merajhasan88/BEBCL-JPEG-Decoder/test_images/IMG20260716020409.jpg

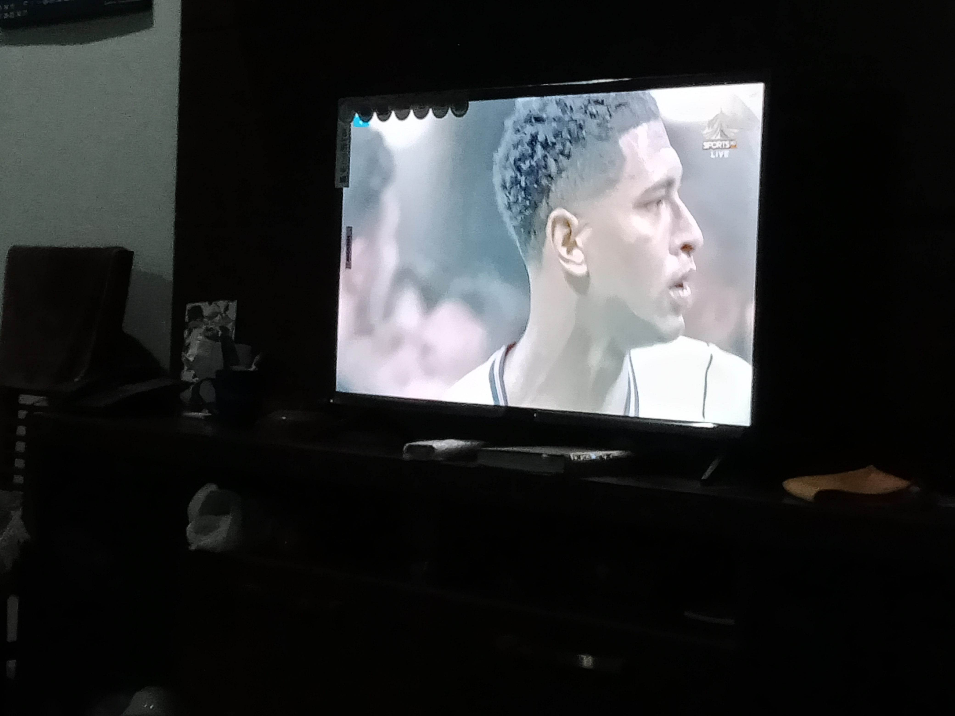
test_images/IMG20260716020409.jpg
