merajhasan88/BEBCL-JPEG-Decoder/bench/doc/head.md

# Benchmarks: this decoder vs. CPU decoders and other FPGA decoders

Measured on 2026-09-30 on the owner's laptop and the owner's EP2C5 board, and on 2026-10-03 on a
remote Artix-7 board (fpgas.online). **Everything here is
single-image decode time with the JPEG already in memory (CPU) or already streaming into the
decoder (FPGA): the time to get the file in and the pixels out is not included.** Generated by
`bench/make_benchmarks_md.py`.

## Setup

| | |
|---|---|
| Images | the owner's own photos (4000x3000 phone photos of a screen, a 3120x4160 4:2:2 photo, a 1944x2592 4:4:4 photo), three small files made from them, and donald.jpg (2048x1365, the photo used since the project started). Of these only `test_images/adapter.jpg` (the 3120x4160 photo) and the two `adp_`/`board_` files are in the repository; `scr_320x240_q90_420` was made from a screen photo, and the test set now has `adp_320x240_q90_420` (same settings, made from adapter.jpg) instead. `bench/run_bench.py` measures the files in `test_images/` by default |
| CPU | Intel Core i7-8550U (Kaby Lake R, 4 cores / 8 threads, 1.8 GHz base, 4.0 GHz turbo), Ubuntu 22.04 |
| CPU clock | the laptop's `performance` power profile, held for the CPU runs (`BENCH_POWER_PROFILE=performance python3 run_bench.py`); average clock measured with `perf stat` during every run: 3.4-3.9 GHz (the laptop throttles), so every comparison with the FPGA uses the CPU times rescaled to a steady 3.9 GHz from each run's cycle count (column "ms at 3.9 GHz"), the CPU's best case. The laptop is normally in its `power-saver` profile (~1 GHz): earlier versions of this file were measured that way without anyone noticing, which made every CPU decoder look about 4-5x slower (see "Correction" below) |
| CPU decoders | libjpeg-turbo 2.1.2 (C API, `-O2 -march=native` harness), libjpeg 9e (built by `bench/tools.py`), stb_image v2.27, Pillow 9.0.1, OpenCV 4.7.0 (`cv2.setNumThreads(1)`), FFmpeg 4.4.2 (its own mjpeg decoder, `-threads 1`, converting to RGB24 like the others); on the 2026-10-04 photo run also zune-jpeg 0.4.21 (Rust, run-time SIMD, built with Rust 1.99) and Go 1.27.1's standard `image/jpeg` (YCbCr converted to RGBA with `image/draw`); each pinned to one core (`taskset -c 3`), repeated in ~0.1 s batches for >= 1.5 s, median batch reported |
| This decoder | the fast core (`FAST=1`, MCU order, RGB) at 95 MHz on the EP2C5 (`boards/ep2c5/fpga_jtag`, 4,473 of 4,608 LEs at the time, timing met at 95 MHz): **clock counts measured on the board** with the decoder clock gated so that streaming time is excluded, identical to the cycle-exact simulation for every image; and the compact core (`FAST=0`, `boards/ep2c5/fpga`, 50 MHz) from simulation |
| Output | CPU decoders: RGB, raster order (libjpeg-turbo default and Pillow/OpenCV with smoothed chroma, `-nosmooth` and this decoder with replicated chroma: same pixels as libjpeg 9e `djpeg -nosmooth`); this decoder: RGB in MCU order (8x8 / 16x16 tiles, each pixel tagged with x, y) |
| Energy | CPU: RAPL package energy over the run / decodes (includes background package power); FPGA: PowerPlay vectorless estimate x decode time (low confidence) - neither is precise enough to compare energy closely |

Not measured: the laptop's Intel UHD 620 hardware JPEG decoder and GPU decoders (not available here).

## Results per image
