merajhasan88/BEBCL-JPEG-Decoder/tb/corpus/SOURCES.md

# Test corpus: origin of every file

Generated by `scripts/make_corpus.py` from the project owner's photo `test_images/adapter.jpg` with ImageMagick and libjpeg-turbo `cjpeg`. Metadata is stripped.

| file | source photo | size | scaling | settings |
|---|---|---|---|---|
| adp_8x8_q10_gray.jpg | adapter.jpg | 8x8 | centre crop | grey, -baseline -quality 10 |
| adp_1x1_q50_420.jpg | adapter.jpg | 1x1 | centre crop | -baseline -quality 50 -sample 2x2 |
| adp_3x5_q50_420.jpg | adapter.jpg | 3x5 | centre crop | -baseline -quality 50 -sample 2x2 |
| adp_5x3_q50_420.jpg | adapter.jpg | 5x3 | centre crop | -baseline -quality 50 -sample 2x2 |
| adp_4x6_q50_422.jpg | adapter.jpg | 4x6 | centre crop | -baseline -quality 50 -sample 2x1 |
| adp_13x11_q40_gray.jpg | adapter.jpg | 13x11 | centre crop | grey, -baseline -quality 40 |
| adp_16x16_q25_420.jpg | adapter.jpg | 16x16 | centre crop | -baseline -quality 25 -sample 2x2 -optimize |
| adp_16x16_q25_gray.jpg | adapter.jpg | 16x16 | centre crop | grey, -baseline -quality 25 -optimize |
| adp_17x33_q40_420.jpg | adapter.jpg | 17x33 | centre crop | -baseline -quality 40 -sample 2x2 |
| adp_32x32_q25_420.jpg | adapter.jpg | 32x32 | centre crop | -baseline -quality 25 -sample 2x2 -optimize |
| adp_32x32_q25_444.jpg | adapter.jpg | 32x32 | centre crop | -baseline -quality 25 -sample 1x1 -optimize |
| adp_33x18_q40_440.jpg | adapter.jpg | 33x18 | centre crop | -baseline -quality 40 -sample 1x2 |
| adp_40x40_q40_lumasub.jpg | adapter.jpg | 40x40 | centre crop | -baseline -quality 40 -sample 1x1,2x2,2x2 |
| adp_48x40_q40_mixed.jpg | adapter.jpg | 48x40 | centre crop | -baseline -quality 40 -sample 2x2,1x2,2x1 |
| adp_40x50_q30_420_rst3.jpg | adapter.jpg | 40x50 | centre crop | -baseline -quality 30 -sample 2x2 -restart 3B |
| adp_45x37_q30_420_rst2.jpg | adapter.jpg | 45x37 | centre crop | -baseline -quality 30 -sample 2x2 -restart 2B |
| adp_45x37_q30_422.jpg | adapter.jpg | 45x37 | centre crop | -baseline -quality 30 -sample 2x1 |
| adp_45x37_q30_440_rst1row.jpg | adapter.jpg | 45x37 | centre crop | -baseline -quality 30 -sample 1x2 -restart 1 |
| adp_45x37_q30_gray_rst3.jpg | adapter.jpg | 45x37 | centre crop | grey, -baseline -quality 30 -restart 3B |
| adp_64x64_q25_420.jpg | adapter.jpg | 64x64 | centre crop | -baseline -quality 25 -sample 2x2 -optimize |
| board_352x32_q6_420.jpg | adapter.jpg | 352x32 | centre band | -baseline -quality 6 -sample 2x2 |
| wide_352x20_q20_420.jpg | adapter.jpg | 352x20 | centre band | -baseline -quality 20 -sample 2x2 |
| wide_368x20_q20_420.jpg | adapter.jpg | 368x20 | centre band | -baseline -quality 20 -sample 2x2 |
| wide_384x12_q20_444.jpg | adapter.jpg | 384x12 | centre band | -baseline -quality 20 -sample 1x1 |
| wide_576x10_q20_422.jpg | adapter.jpg | 576x10 | centre band | -baseline -quality 20 -sample 2x1 |
| wide_592x10_q20_422.jpg | adapter.jpg | 592x10 | centre band | -baseline -quality 20 -sample 2x1 |
| wide_1152x6_q20_gray.jpg | adapter.jpg | 1152x6 | centre band | grey, -baseline -quality 20 |
| wide_1160x6_q20_gray.jpg | adapter.jpg | 1160x6 | centre band | grey, -baseline -quality 20 |
| adp_160x120_q95_444.jpg | adapter.jpg | 160x120 | centre crop | -baseline -quality 95 -sample 1x1 |
| adp_320x240_q90_420.jpg | adapter.jpg | 320x240 | centre crop | -baseline -quality 90 -sample 2x2 |
| adp_240x320_q95_422_rst4.jpg | adapter.jpg | 240x320 | centre crop | -baseline -quality 95 -sample 2x1 -restart 4B |
| adp_256x64_q98_gray.jpg | adapter.jpg | 256x64 | centre crop | grey, -baseline -quality 98 |
| adp_45x37_q30_progressive_UNSUPPORTED.jpg | adapter.jpg | 45x37 | centre crop | -baseline -quality 30 -progressive |
| adp_40x40_q20_sof1_UNSUPPORTED.jpg | adapter.jpg | 40x40 | centre crop | -quality 20 -sample 2x2 |
| adp_45x37_q30_422_exifthumb.jpg | adapter.jpg | 45x37 | centre crop | adp_45x37_q30_422 with an APP1 embedding adp_8x8_q10_gray and a COM containing FF D9 |
