merajhasan88/BEBCL-JPEG-Decoder/tb/corpus/adp_160x120_q95_444.jpg

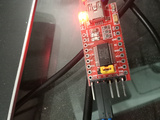
tb/corpus/adp_160x120_q95_444.jpg
