merajhasan88/BEBCL-JPEG-Decoder/tb/corpus/adp_240x320_q95_422_rst4.jpg

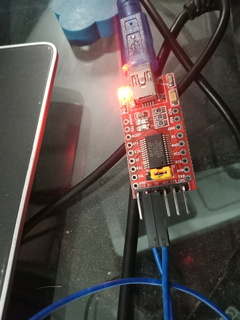
tb/corpus/adp_240x320_q95_422_rst4.jpg
