merajhasan88/BEBCL-JPEG-Decoder/tb/stream_tests2.txt

done mcu
done fmcu
done frbox
done frfancy
done rbox
done rfancy
done ep2c5
done noyrgb
STREAM TESTS 80/80 passed
stream_rc=0
