merajhasan88/BEBCL-JPEG-Decoder/test_images/IMG20260405182829.jpg

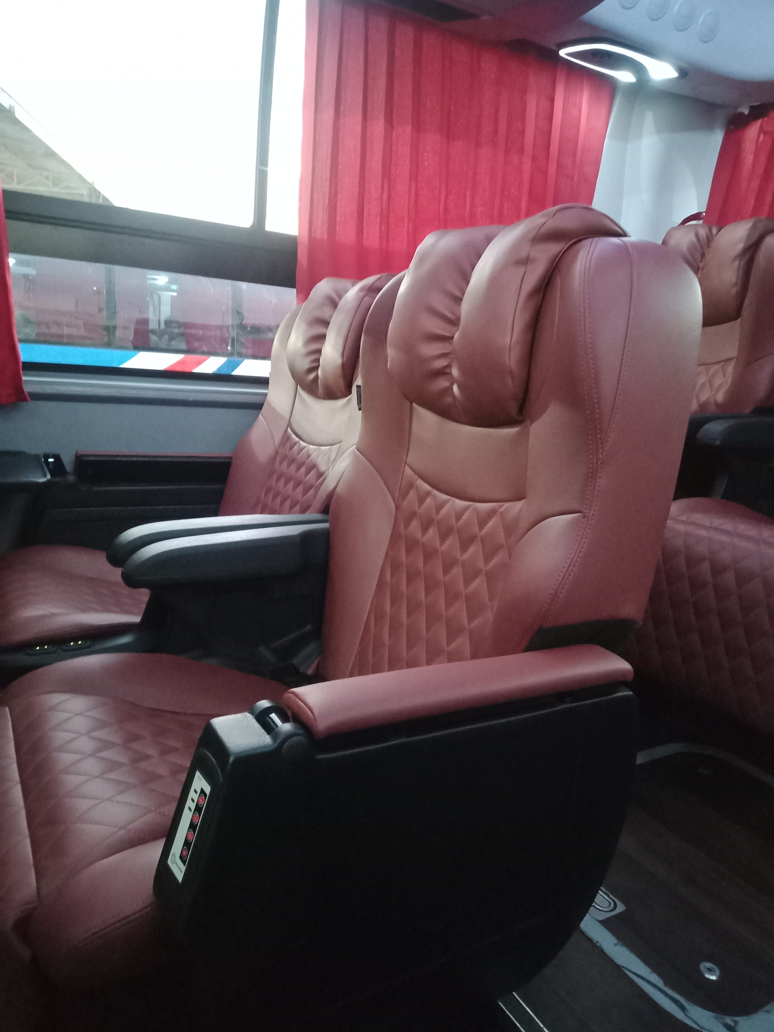
test_images/IMG20260405182829.jpg
