merajhasan88/BEBCL-JPEG-Decoder/test_images/IMG20260405182833.jpg

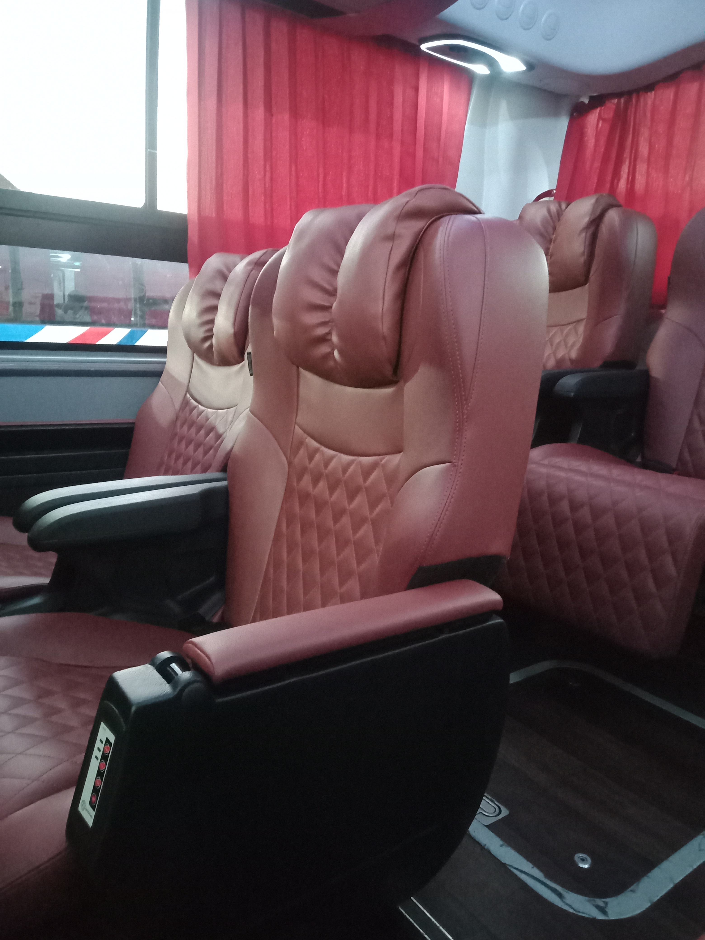
test_images/IMG20260405182833.jpg
