merajhasan88/BEBCL-JPEG-Decoder/test_images/IMG20260425135544.jpg

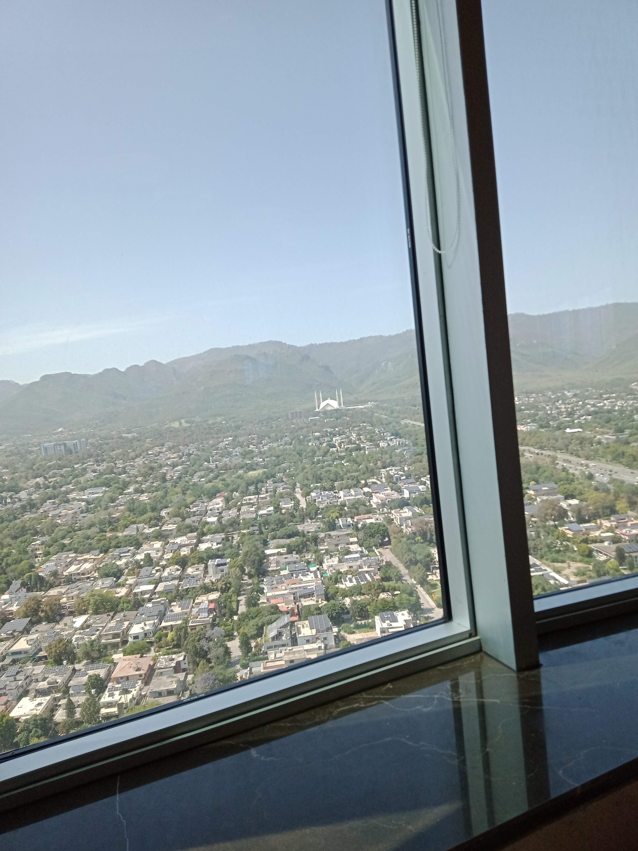
test_images/IMG20260425135544.jpg
