merajhasan88/BEBCL-JPEG-Decoder/test_images/IMG20260425141210.jpg

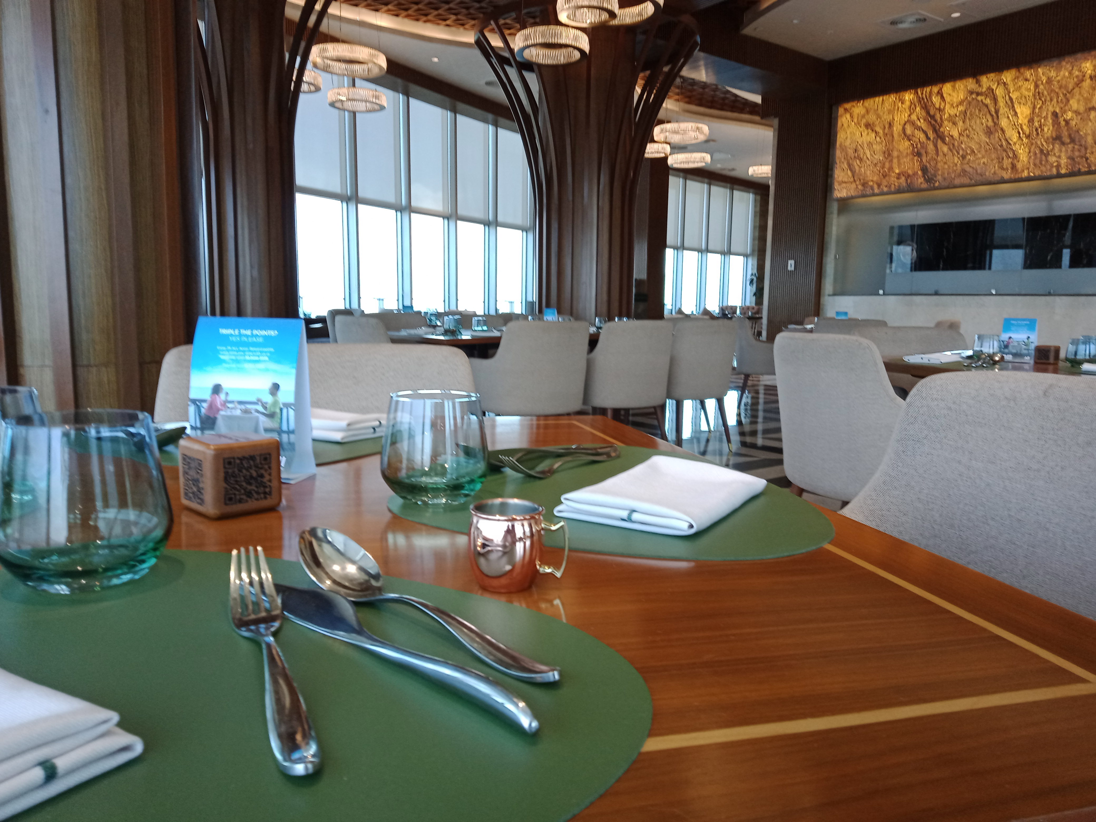
test_images/IMG20260425141210.jpg
