merajhasan88/BEBCL-JPEG-Decoder/test_images/IMG20260523191343.jpg

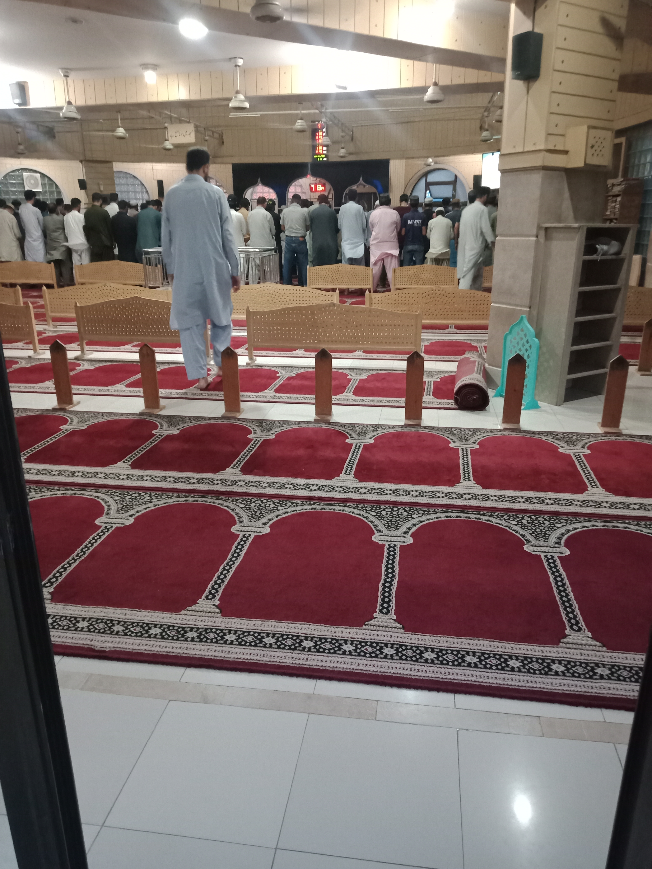
test_images/IMG20260523191343.jpg
