merajhasan88/BEBCL-JPEG-Decoder/test_images/IMG20260612210949.jpg

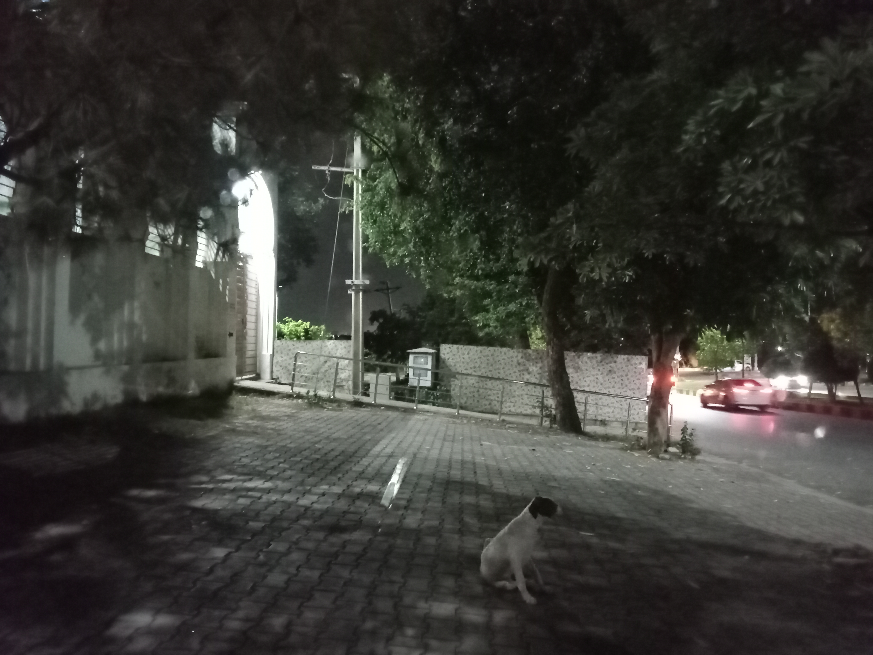
test_images/IMG20260612210949.jpg
