merajhasan88/BEBCL-JPEG-Decoder/test_images/IMG20260716020424.jpg

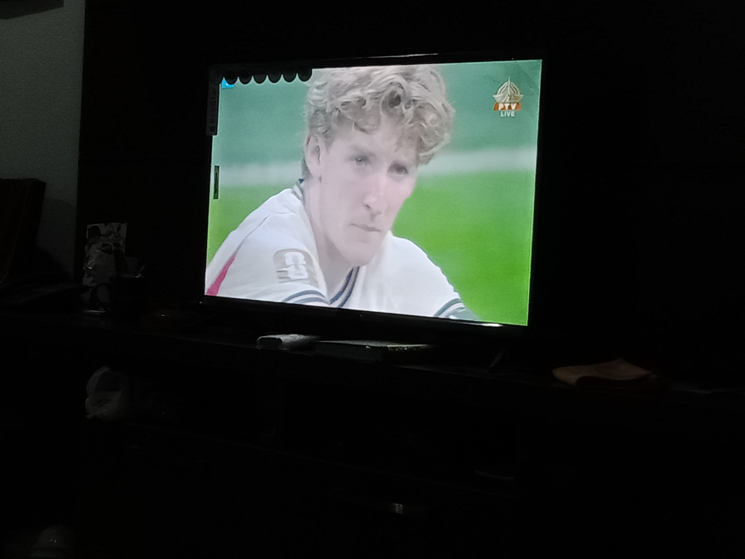
test_images/IMG20260716020424.jpg
