merajhasan88/BEBCL-JPEG-Decoder/test_images/IMG20260723160735.jpg

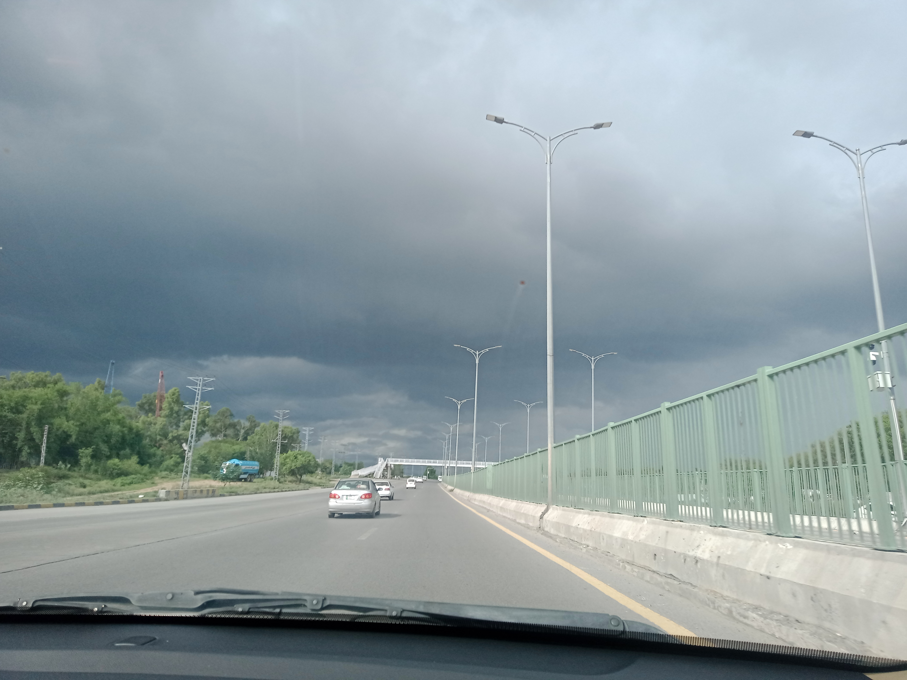
test_images/IMG20260723160735.jpg
