merajhasan88/BEBCL-JPEG-Decoder/(commit log)

2026-10-03 Add the claude_jpeg baseline JPEG decoder library
    Synthesizable SystemVerilog baseline JPEG decoder (ITU-T T.81: SOF0, Huffman, 8-bit,
    1 or 3 components, sampling factors 1-2, restart intervals, EXIF/APPn skipping) with
    bytes-in / pixels-out valid-ready streaming, two cores behind one interface (compact
    FAST=0, pipelined FAST=1 at ~1 clock/pixel), MCU or raster output, and bit-exact
    profiles for libjpeg 9e and libjpeg-turbo/Pillow/OpenCV.
    - rtl/: decoder, header/table validation (CHECKS), end-of-input contract (in_last),
    EP2C5 board tops (ROM + UART demo, JTAG streaming with on-chip clock counting)
    - model/: bit-exact Python reference
    - tb/: Verilator testbenches and regressions (corpus,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
    [cmp_wrap.sv, cycloneii_cells.v, fpga_jtag_top.sv]
2026-10-03 Restructure as BEBCL-JPEG-development; Artix-7 board results
    The library is now called BEBCL-JPEG. This branch (BEBCL-JPEG-development) is the full
    working tree; the main branch (the library) is exported from it by
    scripts/export_library.py.
    Layout
    - rtl/ holds only the vendor-neutral decoder.
    - boards/ep2c5/: the EP2C5 tops, Quartus projects, host scripts, board
    simulations and gate-level flows (were rtl/, quartus/, scripts/, tb/, gls/).
    - boards/acorn_cle215/: Artix-7 XC7A200T (fpgas.online) UART measurement
    harness, Vivado build, host script and results of the 2026-10-03 run.
    - test_images/: the owner's 12 test photos.
    - tb/corpus: every test file is now made from test_images/adapter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
2026-10-04 SystemVerilog testbench, CPU comparison on the photos, RTL portability fixes
    Ways to run the decoder (all three simulate the same RTL cycle by cycle):
    - tb/tb_jpeg.sv: a SystemVerilog testbench (file I/O, stalls, golden
    compare, back-to-back files) for Verilator --binary or Vivado xsim;
    decode.sh decodes test_images/, tb/sim.sh builds and runs it,
    tb/run_tests.sh is the 2,112-run regression without Python or C++.
    Its expectations (tb/expected.txt, stream_scenarios.txt,
    malformed/cases.txt) are written by tb/export_expectations.py; the
    reference images tb/golden/ are now kept in git.
    - the C++ harness: make -C tb decode; Python: scripts/decode.py.
    RTL: Vivado's xsim found two po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
    [export_expectations.py, jpeg_dec_small.sv, jpeg_idct_fast.sv, jpeg_raster_fast.sv, main.rs]
2026-10-04 BEBCL-JPEG Decoder: a bit-exact, backwards-compatible JPEG decoder in SystemVerilog
    Streaming baseline JPEG decoder (ITU-T T.81 SOF0, Huffman, 8-bit samples):
    bytes in, pixels out, no processor, no frame buffer, no vendor primitives.
    Two cores behind one interface (compact, ~13.6 clocks/pixel; pipelined,
    1.0-2.4 clocks/pixel), MCU-order or raster output, bit-exact with libjpeg 9e
    or with Pillow/OpenCV/libjpeg-turbo depending on the build options.
    Measured on an Intel/Altera Cyclone II EP2C5 (95 MHz) and a Xilinx Artix-7
    XC7A200T (150 MHz).
    - rtl/: the decoder (rtl/files.f lists it in compile order)
    - decode your own JPEGs (test_images/) in simulation, three ways:
    ./decode.sh (SystemVerilo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
2026-10-04 README: check the comparison with the other decoders against the data
    Correct the "What sets it apart" section against the measurements in
    BENCHMARKS.md and boards/acorn_cle215: aq_djpeg also ran at 150 MHz (ours
    has the highest Fmax, not the highest board clock), the other decoders'
    differences from libjpeg, the commercial core is CAST's JPEG-DX-F (2-32
    colour samples per clock, so "least clocks per pixel" holds among
    open-source decoders), aq_djpeg's progressive support is its README's claim.
    Claude-Session: https://claude.ai/code/session_01WMk6bNdWggHtk6k7auEFxE
2026-10-05 Batched mode: 15 wide decoders on one Artix-7, measured on the board
    boards/acorn_cle215 gains a batched harness: N decoder lanes behind one
    UART (bench_lane.sv, uart_batch_core.sv, acorn_batch_top.sv), each lane
    with its own gated clock so that its clock count is its decode time;
    files sent lane after lane in packets or broadcast to every lane,
    results returned as lanes finish (pi_batch.py); a Verilator simulation
    (sim/batch_sim_top.sv, sim/tb_batch.cpp); build_batch.tcl in three
    Vivado processes to keep memory low.
    On the Acorn CLE-215+ at fpgas.online (2026-10-05): 15 x FAST=2 at
    150 MHz, met for the board's -3 grade (141.5 MHz on -2); 18/18 results
    identical to libjpeg 9e with every clo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
